a-styuf/norbi_linking_module/Project Outputs for norbi_lm/ExportIDF/IDFReport_norbi_lm.html

Altium customize

# IDF File Translation Report

Date: | | 08.06.2021
Time: | | 10:12:27
Elapsed Time: | | 00:00:00
PCB Filename | : | D:\YandexDisk\Work\Altium\NSU\Норби\Модуль сопряжения\norbi_linking_module\norbi_lm.PcbDoc
IDF Board Filename | : | D:\YandexDisk\Work\Altium\NSU\Норби\Модуль сопряжения\norbi_linking_module\Project Outputs for norbi_lm\ExportIDF\norbi_lm.brd
IDF Library Filename | : | D:\YandexDisk\Work\Altium\NSU\Норби\Модуль сопряжения\norbi_linking_module\Project Outputs for norbi_lm\ExportIDF\norbi_lm.pro

Errors

Back to top

Warnings

Back to top

Save Warnings

Back to top

Save Errors

Back to top

Export Warnings

Back to top

Export Errors

Back to top
