a-styuf/norbi_linking_module/Norby_lm_Error_list.docx

Ошибки версий.

1.0:

1. Неправильный схематик ISO1042 (U17, U18). В отличии от ISO1050 поменяли назначение 2-й и 3-й ноги. Исправлять в схеме ПН как на рисунке ниже.

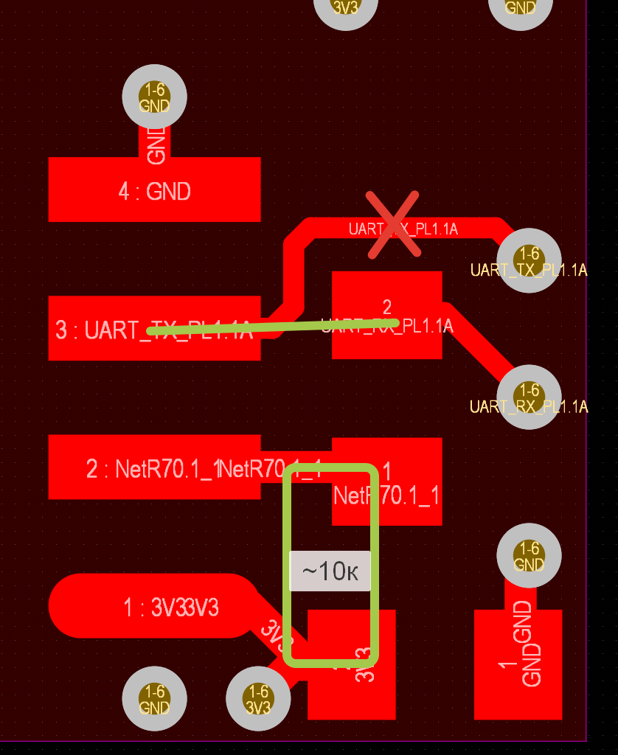
[picture p1: figure]
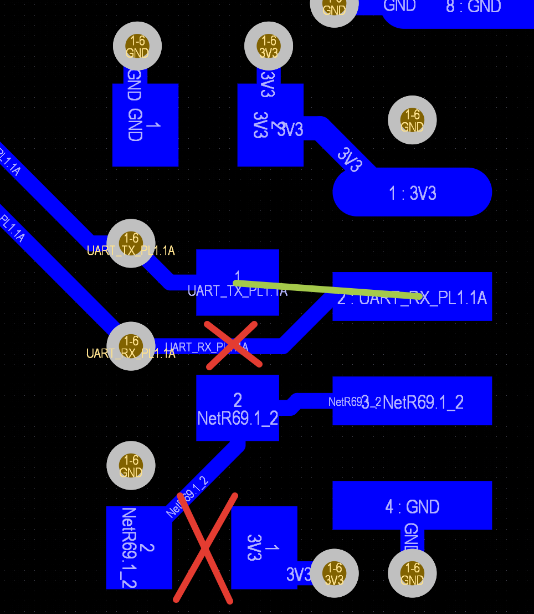
[picture p2: figure]

2. В версии 1.0 У ПН1.1А перепутаны CAN_RX и CAN_TX. У остальных корректно.
3. Логический элемент NC7SZ57P6X необходимо перевести в режим NXOR.

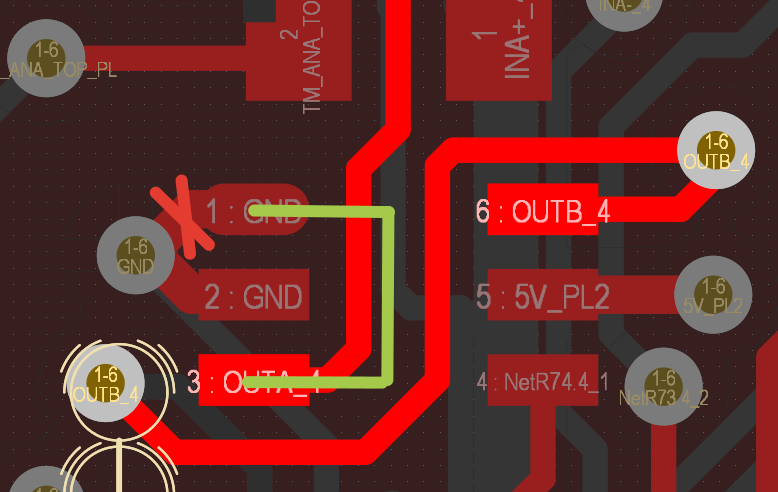
[picture p3: figure]

\

4. У компаратора ADCMP395ARMZ выход типа открытый коллектор. Необходимо подтянуть их к питанию через 20к.

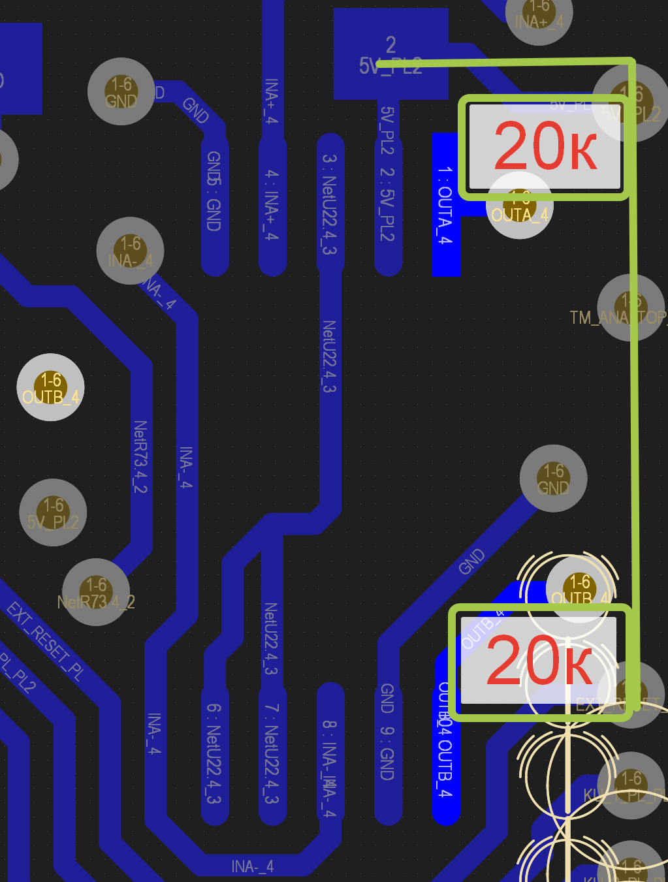
[picture p4: figure]

5. Подтянуть SWO (X1) к питанию через 10-20кОм.

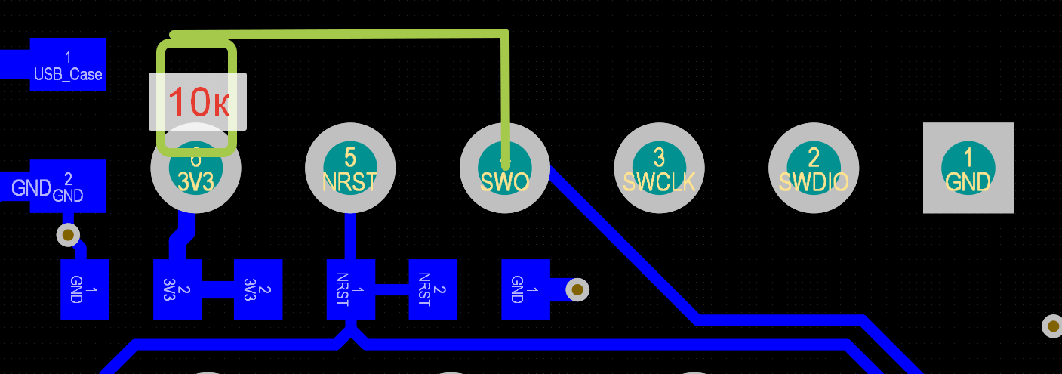
[picture p5: figure]

6. Необходимо перебросить сигнал UART_TX_PLDCR_LM c 98-й ноги на 96-ю.

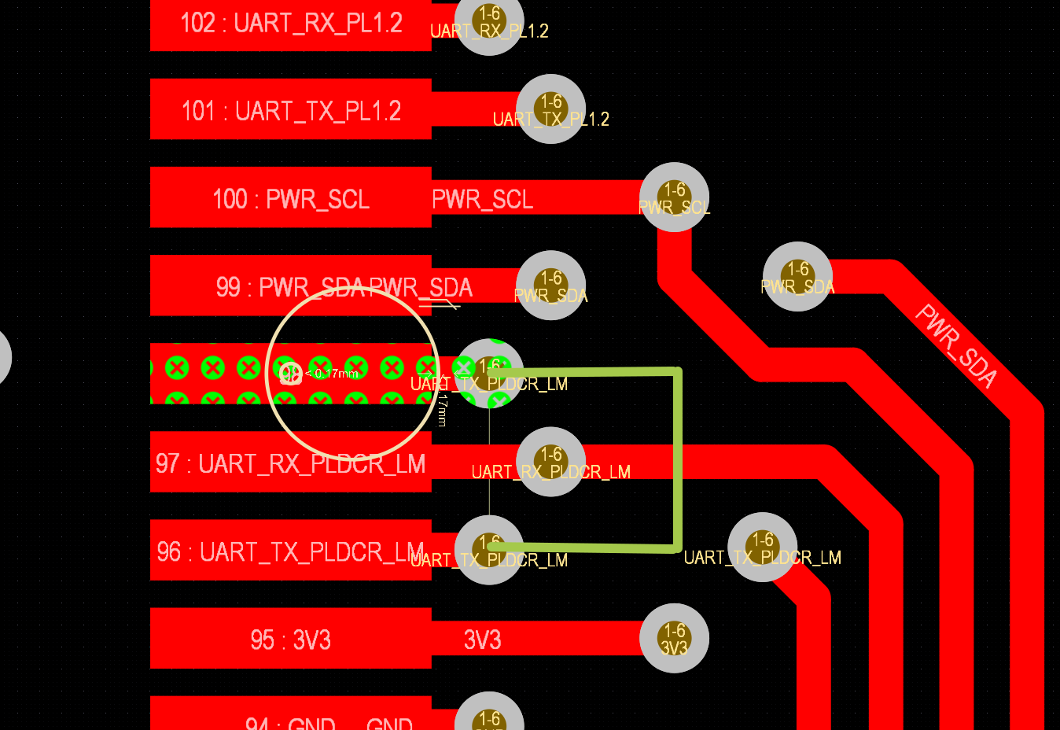
[picture p6: figure]

7. U8, U9 поменять 2-ю и 3-ю ноги местами (из-за ошибки схематика ISO1042).

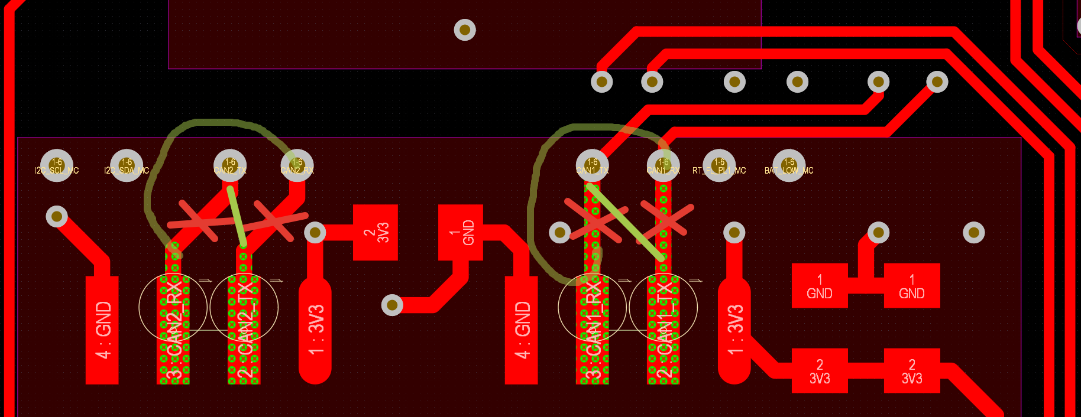
[picture p7: figure]

8. R17 заменить номинал на 12-15к, R18 заменить наминал на 2-3к.
9. R34.2, R35.2 установить по 10к (не хватает подтяжки для 400кБ I2C).
