a-styuf/norbi_linking_module/Project Outputs for norbi_lm/BOM/Bill of Materials-norbi_lm.xlsx

Designator | Назначение | Наименование | Value | Quantity
X3 | Micro-USB разъем на плату | Micro-BF |  | 1
X2 | MOLEX PicoBlade 8-pin to board | MOLEX-PB-8-R |  | 1
X1 | Отладочный разъем | PLS-6 |  | 1
VT2 | Digital Transistor (BRT), R1=4.7 kOhm, R2=47 kOhm, NPN Transistor, 3-Pin | PDTC143ZT |  | 1
VT1 | Resistor-equipped transistors, R1=R2=2k, PNP Transistor, 3-Pin SC-70 | PDTA123JU |  | 1
VD2 | Диод шотки | MBR0540 |  | 1
VD1 | Диод 150мА 100В | 1N4148WS |  | 1
V1, V2, V3_1, V3_2, V3_3, V3_4, V4_1, V4_2, V4_3, V4_4 | Защитная диодная сборка CAN-шины от ЭСР | PESD2CAN |  | 10
U22_1, U22_2, U22_3, U22_4 | Dual Comparators with Accurate Reference Output | ADCMP395ARMZ |  | 4
U21_1, U21_2, U21_3, U21_4 | Universal Configurable 2-Input | NC7SZ57P6X |  | 4
U19_1, U19_2, U19_3, U19_4, U20_1, U20_2, U20_3, U20_4 | 4-канальный цифровой изолятор | ADuM1400 |  | 8
U13, U14, U15, U16 | 4Mb Serial 3V FRAM Memory | CY15B104Q-LHXI |  | 4
U10 | Low-Power Bidirectional I2C Isolators | ISO1540D |  | 1
U8, U9, U17_1, U17_2, U17_3, U17_4, U18_1, U18_2, U18_3, U18_4 | Изолированный CAN приемник | ISO1042DWV |  | 10
U7 | Датчик температуры I2C | TMP1075DR |  | 1
U6_1, U6_2, U6_3, U6_4, U6_5, U12_1, U12_2 | High-Side or Low-Side Measurement, | INA226 |  | 7
U5_1, U5_2, U5_3, U5_4, U5_5 | 17-V Input 3-A Step-Down Converter MicroSiP™ Module with Integrated Inductor | TPS82130 |  | 5
U3_1, U3_2, U3_3, U3_4, U3_5, U4_1, U4_2, U4_3, U4_4, U4_5, U23_1, U23_2, U24_1, U24_2 | Simple 5-V/12-V eFuse Protection Switches | TPS259261DR |  | 14
U2, U11 | 4-канальный цифровой изолятор | ADuM1402 |  | 2
U1 | ARM Cortex-M4 32-bit MCU+FPU | STM32F405ZGT7 |  | 1
SW1 | Push button | TVAF06 |  | 1
RP1, RP2, RP3, RP4, RP5, RP6 | реперная метка для автоматического монтажа | Реперная метка |  | 6
R81 | Чип-резистор | SMD-0603, 20% | 20k | 1
R78, R79 | Чип-резистор | SMD-0603 20% | 27 | 2
R77_1, R77_2, R77_3, R77_4 | Чип-резистор | SMD-0603 1% | 1к6 | 4
R76_1, R76_2, R76_3, R76_4 | Чип-резистор | SMD-0603 1% | 820 | 4
R75_1, R75_2, R75_3, R75_4 | Чип-резистор | SMD-0603 1% | 2k5 | 4
R73_1, R73_2, R73_3, R73_4 | Чип-резистор | SMD-0603 20% | 0 | 4
R50, R51, R68_1, R68_2, R68_3, R68_4, R72_1, R72_2, R72_3, R72_4 | Чип-резистор | SMD-0603 1% | 120 | 10
R37_2, R37_3, R37_4, R37_5 | Чип-резистор | SMD-0603 1% | 30к | 4
R37_1 | Чип-резистор | SMD-0603 1% | 47к | 1
R33_1, R33_2, R33_3, R33_4, R33_5 | Чип-резистор | SMD-0603 1% | NU | 5
R32_2, R32_3, R32_4, R32_5 | Чип-резистор | SMD-0603 1% | 160к | 4
R32_1 | Чип-резистор | SMD-0603 1% | 150к | 1
R31_1, R34_2, R35_2, R52, R55_1, R55_2, R59_1, R59_2, R69_1, R69_2, R69_3, R69_4 | Чип-резистор | SMD-0603 20% | 10к | 12
R30_1, R30_2, R30_3, R30_4, R30_5, R61_1, R61_2 | Чип-резистор токоизмерительный | PE1206DRM470R015L | 0.015 | 7
R25_1, R26_1, R31_2, R31_3, R31_4, R31_5, R34_1, R34_3, R34_4, R34_5, R35_1, R35_3, R35_4, R35_5, R36_1, R36_2, R36_3, R36_4, R36_5, R41_1, R41_2, R41_3, R41_4, R41_5, R43, R44, R45, R62_1, R62_2, R63_1, R63_2, R64_1, R64_2, R70_1, R70_2, R70_3, R70_4, R71_1, R71_2, R71_3, R71_4, R74_1, R74_2, R74_3, R74_4 | Чип-резистор | SMD-0603 20% | NU | 45
R24_1, R24_2, R24_3, R24_4, R24_5, R25_2, R25_3, R25_4, R25_5, R26_2, R26_3, R26_4, R26_5, R38_1, R38_2, R38_3, R38_4, R38_5, R39_1, R39_2, R39_3, R39_4, R39_5, R40_1, R40_2, R40_3, R40_4, R40_5, R42_1, R42_2, R42_3, R42_4, R42_5, R46, R47, R48, R49, R54_1, R54_2, R58_1, R58_2, R65_1, R65_2, R66_1, R66_2, R67_1, R67_2 | Чип-резистор | SMD-0603 20% | 100 | 47
R23_1, R23_2, R23_3, R23_4, R23_5, R29_1, R29_2, R29_3, R29_4, R29_5 | Чип-резистор | SMD-0603 20% | 100к | 10
R22_1, R22_2, R22_3, R22_4, R22_5, R28_1, R28_2, R28_3, R28_4, R28_5, R56_1, R56_2, R60_1, R60_2 | Чип-резистор | SMD-0603 20% | 300к | 14
R21_1, R21_2, R21_3, R21_4, R21_5, R27_1, R27_2, R27_3, R27_4, R27_5, R53_1, R53_2, R57_1, R57_2 | Чип-резистор | SMD-0603 20% | 1М | 14
R20_1, R20_2, R20_3, R20_4, R80_1, R80_2, R80_3, R80_4 | Чип-резистор | SMD-0603 20% | 20к | 8
R19 | Чип-резистор | SMD-0603, 20% | 500 | 1
R18 | Чип-резистор | SMD-0603, 20% | 3к | 1
R17 | Чип-резистор | SMD-0603, 20% | 13к | 1
R16 | Чип-резистор | SMD-0603, 20% | 5к | 1
R7 | Чип-резистор | SMD-0603, 20% | 1к | 1
R5, R6, R8, R9, R10, R11, R12, R13, R14, R15 | Чип-резистор | SMD-0603, 20% | 10к | 10
R4 | Чип-резистор | SMD-0603, 20% | 27 | 1
R1, R2, R3 | Чип-резистор | SMD-1206, 20% | 0 | 3
R0 | Чип-резистор | SMD-0603, 20% | 0 | 1
L4 | Связанная индуктивность | ACM2012-900-2P | 65Ohm@100MHz | 1
L1, L2, L3, L5 | Чип-индуктивность | Индуктивность | 1мкГн | 4
H3 | Header, 20-Pin, Dual row, Right Angle | PLD2-40 |  | 1
H1, H2 | Сквозной разъем, двойно, 52 контакта, шаг 2,54 мм | ESQ-126-39-G-D |  | 2
GK1 | Кварцевый генератор 7x5мм 20 МГц | VCC1-B3B-10M |  | 1
D4, D5 | ESD защитные диоды | PESD5V0S1BA |  | 2
D3 | Светодиод | LED SMD-0805 | yellow | 1
D2 | Светодиод | LED SMD-0805 | green | 1
D1 | Светодиод | LED SMD-0805 | red | 1
C61, C62 | Чип-конденсатор | SMD-0603 | 22пФ | 2
C58 | Поляризованный чип-конденсатор | Конденсатор танталовый SMD | 10мкФ х 16В | 1
C43_1, C43_2 | Поляризованный чип-конденсатор | Конденсатор танталовый SMD | 10мкФх16В | 2
C28_1, C28_2, C28_3, C28_4, C28_5, C29_1, C29_2, C29_3, C29_4, C29_5, C44_1, C44_2 | Чип-конденсатор | SMD-0603 | 0,22мкФ | 12
C27_1, C27_2, C27_3, C27_4, C27_5 | Поляризованный чип-конденсатор | Конденсатор танталовый SMD | 47мкФх10В | 5
C23_1, C23_2, C23_3, C23_4, C23_5, C25_1, C25_2, C25_3, C25_4, C25_5, C39_1, C39_2, C41_1, C41_2 | Чип-конденсатор | SMD-0603 | 1мкФ | 14
C3, C4, C5, C7, C8, C9, C10, C11, C12, C13, C14, C15, C16, C17, C18, C19, C20, C21_1, C21_2, C21_3, C21_4, C21_5, C22_1, C22_2, C22_3, C22_4, C22_5, C24_1, C24_2, C24_3, C24_4, C24_5, C26_1, C26_2, C26_3, C26_4, C26_5, C30, C31, C32, C33, C34, C35, C36, C37, C38_1, C38_2, C40_1, C40_2, C42_1, C42_2, C45, C46, C47, C48, C49_1, C49_2, C49_3, C49_4, C50_1, C50_2, C50_3, C50_4, C51_1, C51_2, C51_3, C51_4, C52_1, C52_2, C52_3, C52_4, C53_1, C53_2, C53_3, C53_4, C54_1, C54_2, C54_3, C54_4, C55_1, C55_2, C55_3, C55_4, C56_1, C56_2, C56_3, C56_4, C57_1, C57_2, C57_3, C57_4, C59, C60 | Чип-конденсатор | SMD-0603 | 0,1мкФ | 93
C1, C2, C6 | Чип-конденсатор | SMD-0603 | 10мкФ | 3
