a-styuf/norbi_linking_module/(list of files, drawings)

Other design files:
for description.SchDoc
norbi_lm.PrjPcb
norbi_lm_interface.SchDoc
norbi_lm_main.SchDoc
norbi_lm_mem.SchDoc
norbi_lm_pl_dcr.SchDoc
norbi_lm_pl_dcr_power_ch.SchDoc
norbi_lm_pl_interface.SchDoc
norbi_lm_pl_iss.SchDoc
norbi_lm_single_power_ch.SchDoc
norbi_lm_trm.SchDoc
norbi_lm_usb.SchDoc
