a-styuf/norbi_linking_module/(commit log)

2019-12-17 #0.1 Переход на git
    После неудачной работы с встроенной в AD VCS перешел на git.
    Предстоит восстановить все наработки двух дней.
    [norbi_lm_#1.PrjPcb, norbi_lm_interface.SchDoc, norbi_lm_interfaces.SchDoc, norbi_lm_main.SchDoc, norbi_lm_mem.SchDoc, norbi_lm_pl_dcr.SchDoc, norbi_lm_pl_dcr_power_ch.SchDoc, norbi_lm_pl_interface.SchDoc]
2019-12-17 #0.2 Продолжаем переход на git
    После неудачной работы с встроенной в AD VCS перешел на git. Предстоит восстановить все наработки двух дней.
    [norbi_lm_#1.PrjPcb, norbi_lm_pl_iss.SchDoc, norbi_lm_single_power_ch.SchDoc]
2019-12-17 #0.3 Перешел на гит
    - Доделал интерфейсы питания и информационный для ПН ИСС
    [norbi_lm_#1.PrjPcb, norbi_lm_interface.SchDoc, norbi_lm_interfaces.SchDoc, norbi_lm_main.SchDoc, norbi_lm_mem.SchDoc, norbi_lm_pl_dcr.SchDoc, norbi_lm_pl_dcr_power_ch.SchDoc, norbi_lm_pl_interface.SchDoc]
2019-12-18 #0.4 Доразвел интерфейсы к PC104
    - соединил модули питания и информационные с разъемами PC104
    [norbi_lm_pl_iss.SchDoc]
2019-12-19 #0.5 Интерфейсы готовы
    - доразведен интерфейс МС к БКУ;
    - разведен интерфейс к ДСР;
    - разведен разъем к БКУ.
    [norbi_lm_interface.SchDoc, norbi_lm_pl_dcr.SchDoc]
2019-12-20 #0.6 Начало разводки МК
    - начал растягивать линии для МК
    [norbi_lm_main.SchDoc]
2019-12-22 #0.7 Предварительно полностью разведенная плата
    - необходимо посмотреть не замыленным взором.
    [norbi_lm_#1.PrjPcb, norbi_lm_main.SchDoc, norbi_lm_mem.SchDoc, norbi_lm_usb.SchDoc]
2019-12-23 #1.0 Заказ первой версии
    - заказ первой версии платы
    [norbi_lm_#1.PrjPcb]
2020-01-13 #1.0.1 Заказ первой версии
    - найдено спорное место, CANH_RX_1.1A и CANL_RX_1.1A не быkи доведены до via
2020-02-18 #1.1 Найдены ошибки в схеме
    - Найдены ошибки в схеме связанные с неправильным схематиком ISO1042. Поправил в схеме (не в разводке)
    - Добавил в проект файл с ошибками
    [norbi_lm_interface.SchDoc, norbi_lm_main.SchDoc, norbi_lm_pl_dcr_power_ch.SchDoc, norbi_lm_pl_interface.SchDoc, norbi_lm_pl_iss.SchDoc, norbi_lm_single_power_ch.SchDoc, norbi_lm_usb.SchDoc]
2020-05-31 # 1.2 Поправлены названия элементов
    - поправлены названия элементов
    [norbi_lm_#1.PrjPcb, norbi_lm_interface.SchDoc, norbi_lm_main.SchDoc, norbi_lm_mem.SchDoc, norbi_lm_pl_dcr.SchDoc, norbi_lm_pl_dcr_power_ch.SchDoc, norbi_lm_pl_interface.SchDoc, norbi_lm_single_power_ch.SchDoc]
2020-10-29 #2.0 Заказ второй версии #norby_lm_1.1
    - белое покрытие, черная шелкография
    - добавлен знак ОКБ
    - поправлен ряд ошибок
    - добавлена окантовка под автомонтаж
    - добавлены реперные точки
    [norbi_lm.PrjPcb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]
2022-06-20 #2.1 Генерация выходной документации для запайки через draftsman
    [Bill of Materials-norbi_lm.xlsx, for description.SchDoc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]
